ejajmamud/rvm-iot/README.md

# rvm-iot

Hey there! This is a complete project repository featuring JavaScript.

## Why this repository exists
I source and maintain clean, reference codebases across various technologies (including web apps, mobile apps, workflow integrations, and system utilities). This repository is kept public to serve as a reference or clean starting point for fellow developers.

## Tech Stack & Highlights
- **Primary Tech Stack**: JavaScript
- Zero bloat, clean directories, and fully structured.

## How to run or use
1. Clone this repository to your local workspace.
2. Install the necessary dependencies for this stack (e.g., check configuration files like `package.json`, `requirements.txt`, etc.).
3. Run the project according to standard procedures for this environment.

---
Feel free to fork, explore, or reach out if you have any questions!
Created and maintained by [Md Ejaj Mahmud](https://github.com/ejajmahmud).
