ejajmamud/rvm-iot/(commit log)

2026-05-29 feat: align simulated cabinet to physical prototype with 3D panels, blue LCD, Web Audio buzzer, rocker switch, exact tooltips, and circuit wiring schematic
    [main_updated.ino]
2026-05-29 feat: cosmic dark mode dashboard and 100% exact pin-by-pin schematic layout
2026-05-29 fix(layout): close unclosed h3 tag and restructure simulator to a widescreen horizontal stack with schematic below scroll
2026-05-29 fix(mega): upgrade ultrasonic check with majority voting and no-signal safeguard to prevent floating lockups on boot
    [main_updated.ino]
2026-05-29 feat(diagnostics): add live telemetry stats, automated calibration test triggers, fault injection simulation engine, and interactive hardware pinout inspector
2026-05-29 feat(showcase): implement physical RVM prototype progress gallery and interactive datasheet explorer
2026-05-29 fix: ESP32 added, gear fallback for broken icons, Marcellus font enforced, LJ12A3 HTML datasheet, HC-SR04 PDF fixed, servo_icon.jpg downloaded
2026-05-30 feat: full mobile & tablet responsive design — bottom nav, drawer sidebar, hamburger, responsive grids, toast repositioning, all 11 pages
2026-05-30 feat: complete enterprise-grade login PIN for Ejaj, guest read-only restriction, universal Marcellus font coverage, and mobile/tablet responsive design
2026-05-30 feat: add robust image load error fallback handler to prototype gallery images
2026-05-30 feat: auto-switch to simulator tab when clicking 'Run Live Simulation' button
2026-05-30 fix: Resolve Light Theme readability, background contrast, text, and secondary button style issues
2026-05-30 feat: Redesign Login UI and PIN Modal to deliver an elite Enterprise-Grade Auth experience with perfect readability
2026-05-30 feat: replace admin login pin override with credentials form & replace emojis with premium Lucide icons
2026-05-30 fix: target correct diagram SVG in downloadDiagramAsPng, avoiding Lucide button icon SVG
2026-06-01 feat: integrate interactive progress report submissions and final prototype gallery images
2026-06-02 feat: finalize premium high-contrast light theme overhaul for diagram sidebar, chassis details and PNG exports
2026-06-02 feat: upgrade power distribution diagram to 7-block industrial schematic, add persistent theme state, and implement full user and maintenance log CRUD in settings
2026-06-02 feat: complete premium light theme contrast overhaul for supervisor panel, document center, override lockout, pinout dropdown, sonar oscilloscope, and diagnostic calibration components
2026-06-02 feat: widen Firestore DB icon cylinder in Diagram 6 to provide perfect padding around label text
2026-06-02 feat: integrate secure client-side Web API Relay mode for 100% reliable dynamic email notifications bypassing SMTP DNS/port blocks
2026-06-02 fix: force dynamic Web API Relay migration by default in localStorage cache to bypass SmtpJS script blocking
2026-06-02 feat: implement adblocker-proof CORS proxy relay for SMTP credentials
2026-06-03 fix: update Mega firmware sendEvent to output JSON to match ESP32 bridge parser
    [main_updated.ino]
2026-06-03 Fix simulated LCD screen and physical LEDs clobbering bug in simulator events and live event updates
2026-06-03 Refactor Stage 5 simulation updates to be side-effect free and prevent state setting callback race conditions
2026-06-03 Fix Temporal Dead Zone mount crash by hoisting simulation state declarations above hooks
